rockola/Riptide/README.md

# Riptide

Riptide is a true analog spring reverb in pedal format for the DIY community. To learn how it works and see a demo, visit https://scientificguitarist.wixsite.com/home/riptide-spring-reverb.

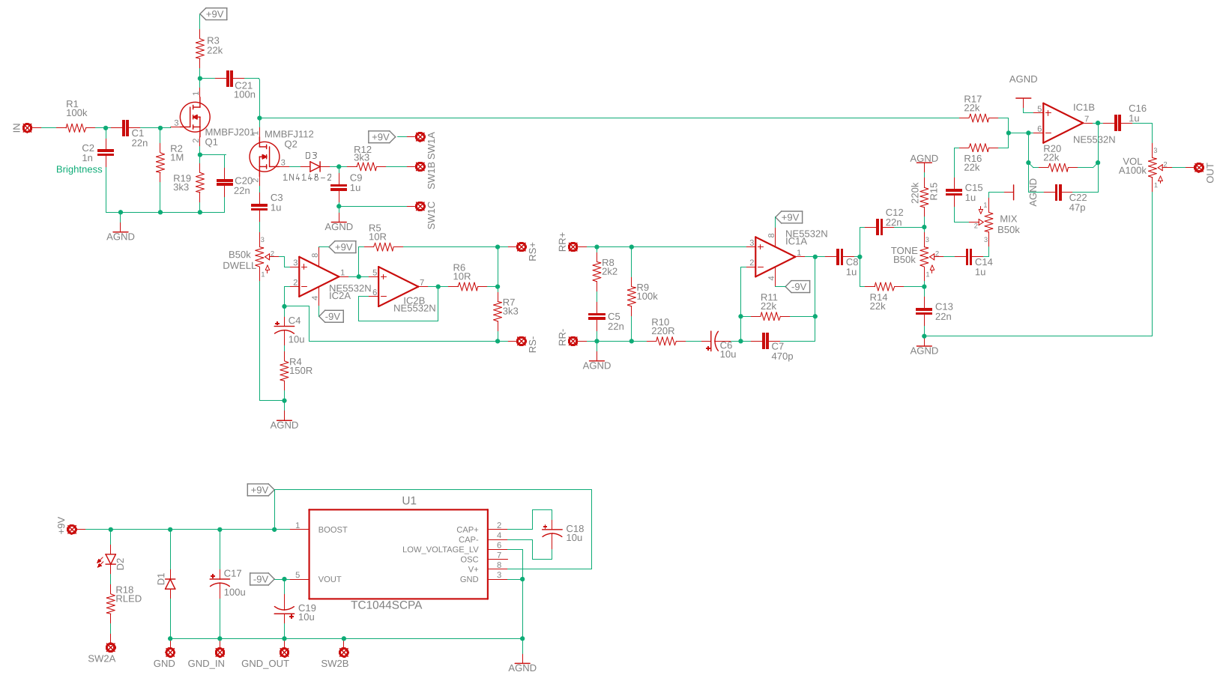
[picture p1: schematic.png]
Schematic
