rockola/Riptide/Riptide_FullSchematic.pdf

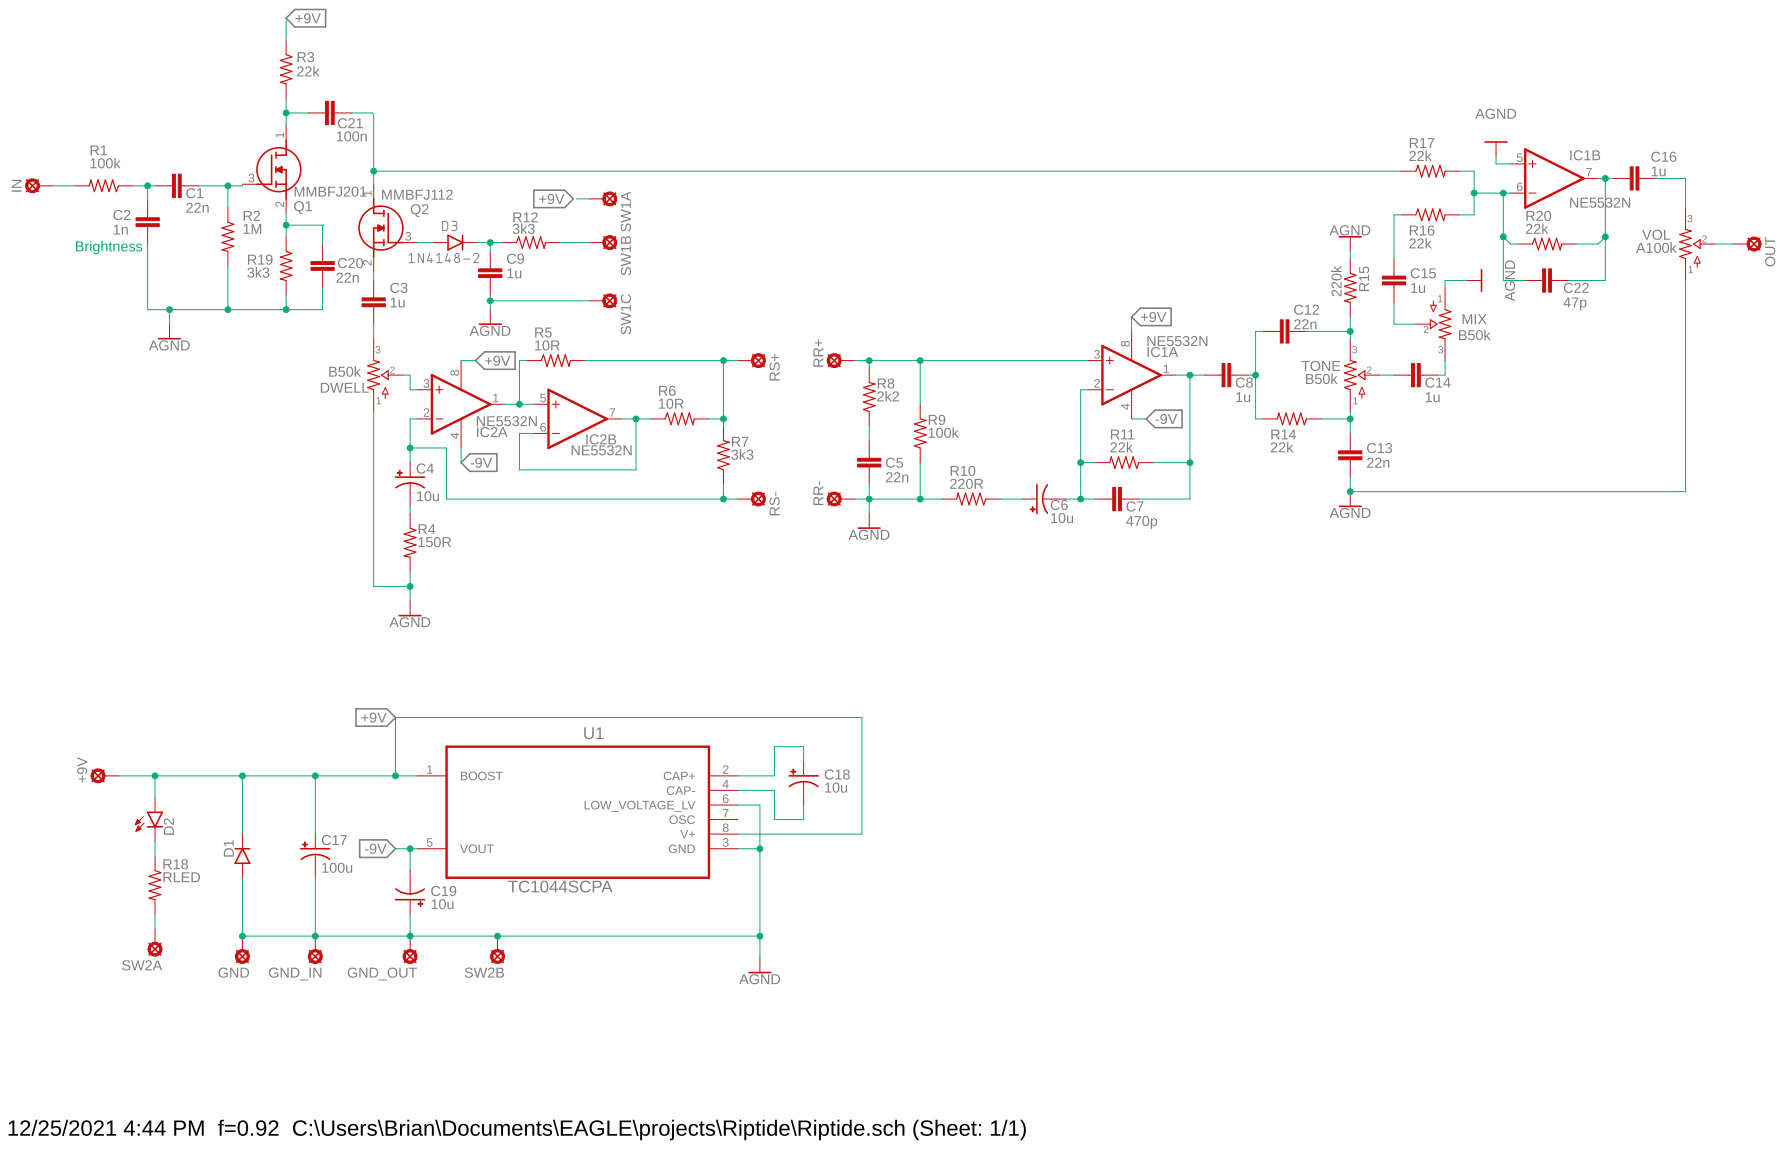
[picture p2: page 1]
