rockola/Riptide/(commit log)

2022-01-12 unpacked zip file
    [BOM_Parts.csv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]
2022-03-14 show schematic
